mdzio/hm-currentloop/doc/prototype1.jpg

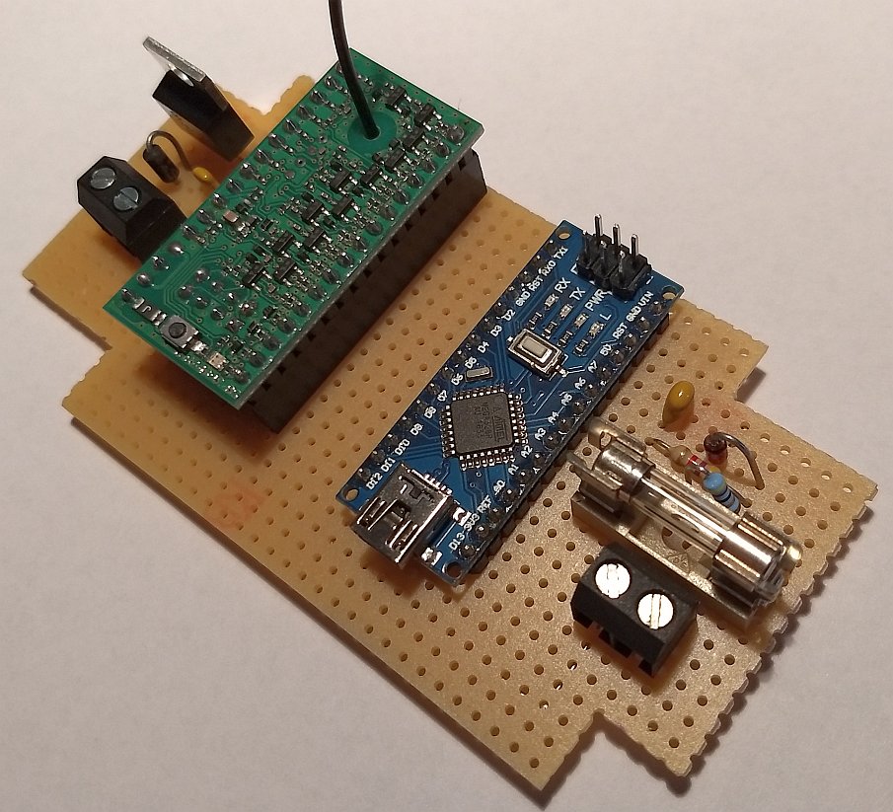
doc/prototype1.jpg
