mdzio/hm-currentloop/doc/prototype2.jpg

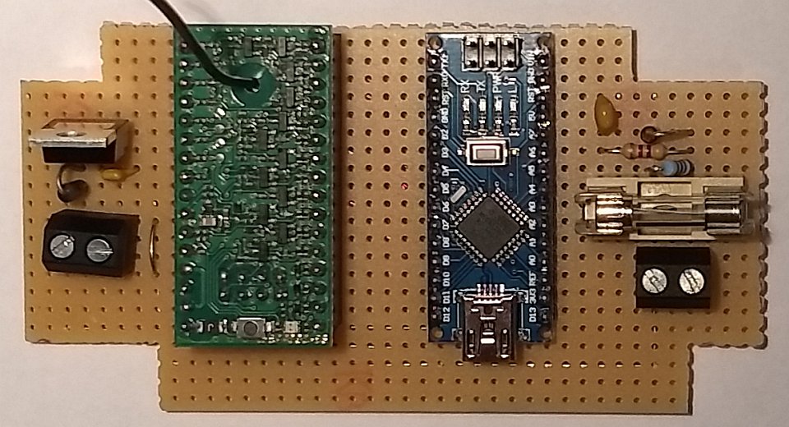
doc/prototype2.jpg
