mdzio/hm-currentloop/doc/prototype3.jpg

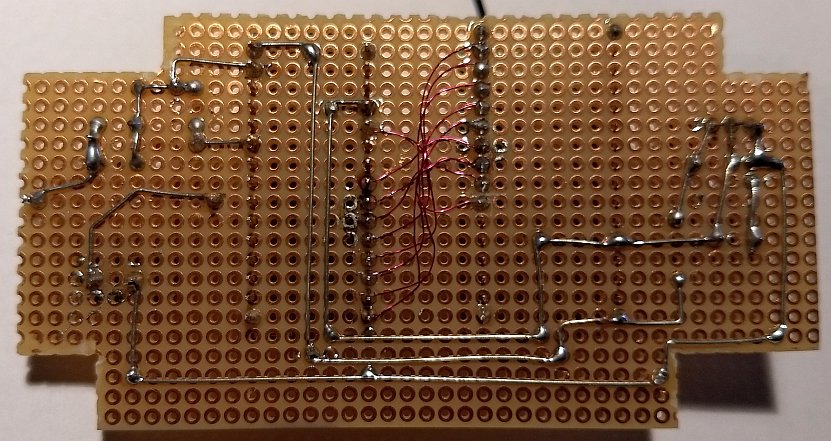
doc/prototype3.jpg
