mdzio/hm-currentloop/hm-currentloop.sch

## EAGLE design hm-currentloop.sch (2019-08-31)

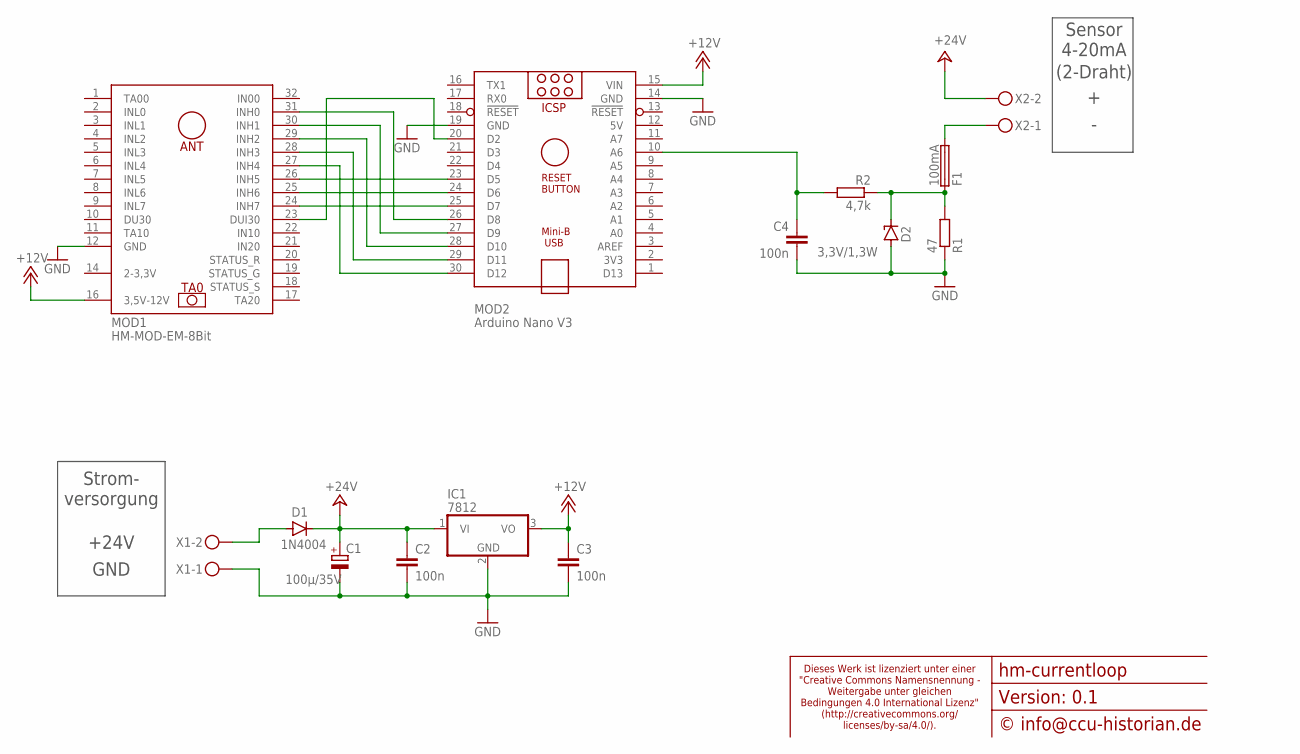
[picture p8: schematic hm-currentloop.sch]

Parts:
C1: 100µ/35V; E5-6
C2, C3, C4: 100n; C050-025X075
D1: 1N4004; DO41-10
D2: 3,3V/1,3W; F126Z10
F1: 100mA; PICOFUSE
IC1: 7812; TO220V
MOD1: HM-MOD-EM-8Bit; HM-MOD
MOD2: Arduino Nano V3; ARDUINO_NANO
R1: 47; 0207/10
R2: 4,7k; 0207/10
X1, X2: MKDSN1,5/2-5,08

Connections:
+12V: C3.1, IC1.3 (VO), MOD1.16 (3,5V-12V), MOD2.15 (VIN)
+24V: C1.+, C2.1, D1.C, IC1.1 (VI), X2.2
GND: C1.-, C2.2, C3.2, C4.2, D2.A, IC1.2 (GND), MOD1.12 (GND), MOD2.14 (GND), MOD2.19 (GND), R1.1, X1.1
unnamed: D1.A, X1.2
unnamed: D2.C, F1.1, R1.2, R2.1
unnamed: F1.2, X2.1
unnamed: C4.1, MOD2.10 (A6), R2.2
unnamed: MOD1.31 (INH0), MOD2.26 (D8)
unnamed: MOD1.30 (INH1), MOD2.27 (D9)
unnamed: MOD1.29 (INH2), MOD2.28 (D10)
unnamed: MOD1.28 (INH3), MOD2.29 (D11)
unnamed: MOD1.27 (INH4), MOD2.30 (D12)
unnamed: MOD1.26 (INH5), MOD2.23 (D5)
unnamed: MOD1.25 (INH6), MOD2.24 (D6)
unnamed: MOD1.24 (INH7), MOD2.25 (D7)
unnamed: MOD1.23 (DUI30), MOD2.20 (D2)

Notes on the sheet:
Sensor 4-20mA
+24V
GND
Strom- versorgung
Dieses Werk ist lizenziert unter einer "Creative Commons Namensnennung - Weitergabe unter gleichen Bedingungen 4.0 International Lizenz" (http://creativecommons.org/ licenses/by-sa/4.0/).
Version: 0.1
© info@ccu-historian.de
(2-Draht)
